hra1129/msx0keyboard/README.md

新プロトコルに関しては、MSX0に採用されるかどうかも分かりませんし、現時点のバージョンではサポートされていませんので、
新バージョンの方は使える環境はありません。未テストです。

キーボードに付いている Grove端子には、プルアップ抵抗(3.3kΩ)を付けなければ機能しません。
G32とG33の二カ所を 3.3kΩ経由で 5V に繋いでください。
