hra1129/msx0keyboard/RaspberryPiPico_Arduino_Sketch/Readme.txt

../KiCad_Project/msx0_keyboard の基板用ファームウェアです。
このファームウェアは２種類のプロトコルを扱います。

	(1) FaceII_keyboard_compatible
		こちらの通信プロトコルは、FaceIIキーボードのプロトコルを使うバージョンです。
		現時点で利用可能である反面、プロトコルの都合によりいくつかのキーを
		入力できない問題があります。

	(2) NewProtocol_MSX0_keyboard  ★こちらがやりたい方！
		こちらの通信プロトコルは、新プロトコルになっております。
		MSX0側が対応していただかなければ、このファームウェアで入力できません。
		対応していただければ、実MSXと同じキー入力を実現できます。
		MSXのキーマトリクス＋ジョイパッド情報を、MSXのPPIの並び順＋PSGの並び順で返すので、
		MSX0本体側もそれをそのまま使えば良く、CPU負荷にも優しいプロトコルになっています。
