hra1129/msx0keyboard/KiCad_Project/readme.txt

それぞれのフォルダにある zip ファイルを、
JLCPCB にアップロードすると発注できます。

m5stack_base は 1mm厚で作って下さい。
ここに M5stack用のピンヘッダを取り付ければ MSX0を取り付けられるようになります。

他は デフォルトの 1.6mm厚で問題ありません。
