hra1129/msx0keyboard/(list of files, drawings)

Other design files:
KiCad_Project/msx0_keyboard/msx0_keyboard.dsn
KiCad_Project/msx0_keyboard_frontpanel/msx0_keyboard.dsn
