hra1129/msx0keyboard/KiCad_Project/m5stack_base/m5stack_base.kicad_pcb

## KiCad design KiCad_Project/m5stack_base/m5stack_base.kicad_pcb (2024-04-21)

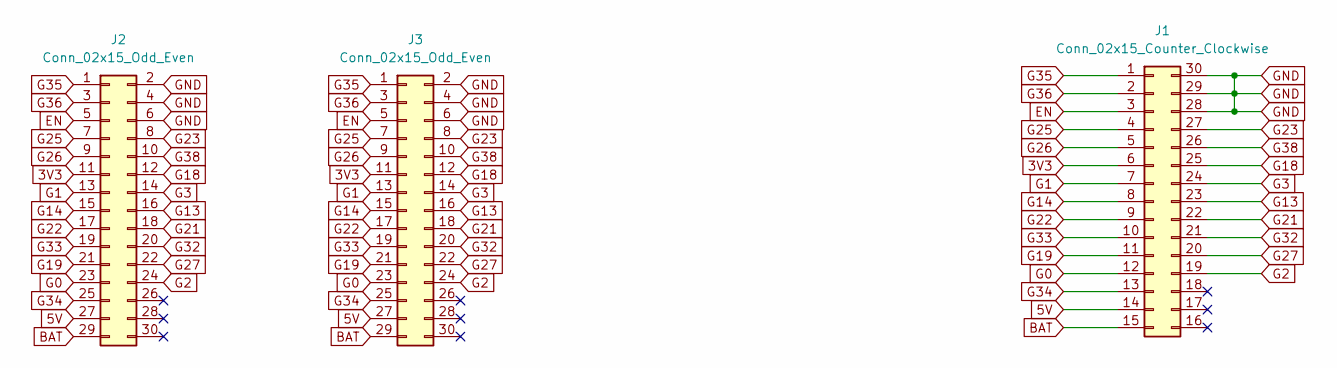
[picture p13: schematic m5stack_base.kicad_sch]

Parts:
J1: Conn_02x15_Counter_Clockwise; M5StackBase2_1
J2, J3: Conn_02x15_Odd_Even; PinHeader_2x15_P2.54mm_Vertical

Connections:
3V3: J1.6, J2.11, J3.11
5V: J1.14, J2.27, J3.27
BAT: J1.15, J2.29, J3.29
EN: J1.3, J2.5, J3.5
G0: J1.12, J2.23, J3.23
G1: J1.7, J2.13, J3.13
G2: J1.19, J2.24, J3.24
G3: J1.24, J2.14, J3.14
G13: J1.23, J2.16, J3.16
G14: J1.8, J2.15, J3.15
G18: J1.25, J2.12, J3.12
G19: J1.11, J2.21, J3.21
G21: J1.22, J2.18, J3.18
G22: J1.9, J2.17, J3.17
G23: J1.27, J2.8, J3.8
G25: J1.4, J2.7, J3.7
G26: J1.5, J2.9, J3.9
G27: J1.20, J2.22, J3.22
G32: J1.21, J2.20, J3.20
G33: J1.10, J2.19, J3.19
G34: J1.13, J2.25, J3.25
G35: J1.1, J2.1, J3.1
G36: J1.2, J2.3, J3.3
G38: J1.26, J2.10, J3.10
GND: J1.28, J1.29, J1.30, J2.2, J2.4, J2.6, J3.2, J3.4, J3.6

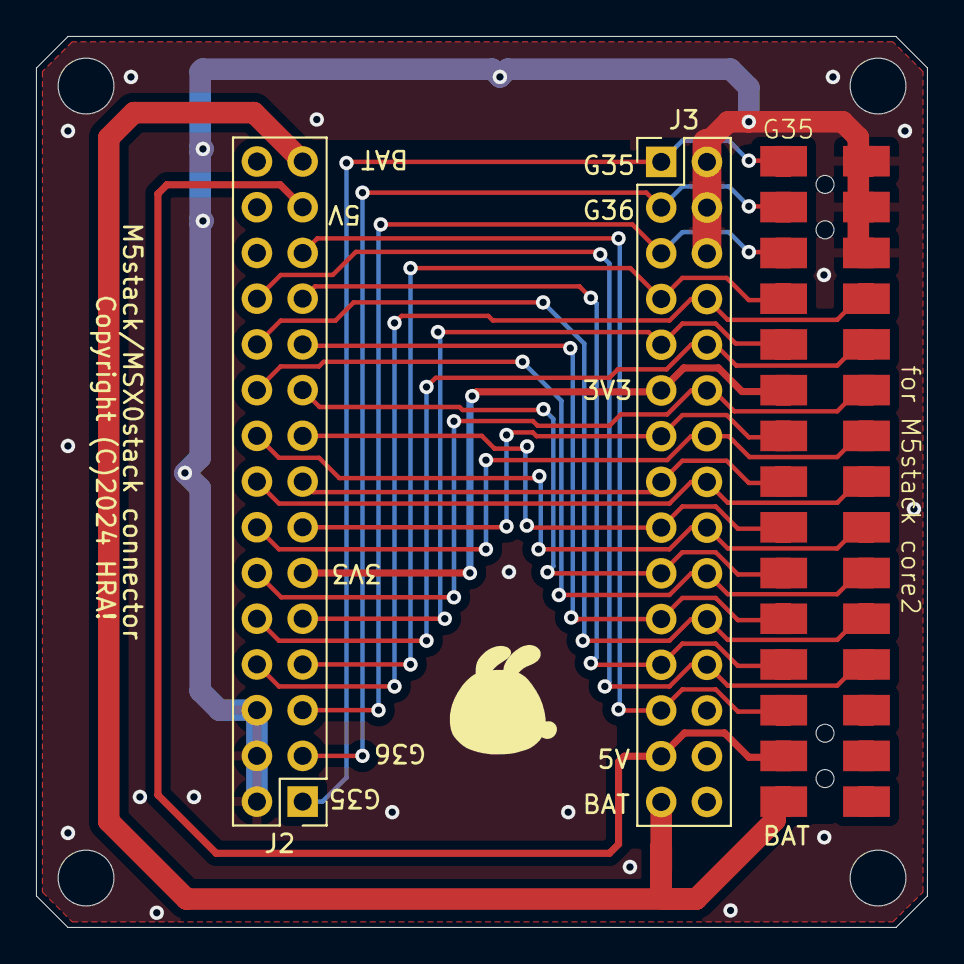
[picture p14: board m5stack_base.kicad_pcb from above]

Board: 2 copper layers, 49.5 x 49.5 mm, 3 parts (0 on the bottom side), 25 nets.
