hra1129/msx0keyboard/KiCad_Project/msx0_keyboard/msx0_keyboard.kicad_pcb

## KiCad design KiCad_Project/msx0_keyboard/msx0_keyboard.kicad_pcb (2024-04-21)

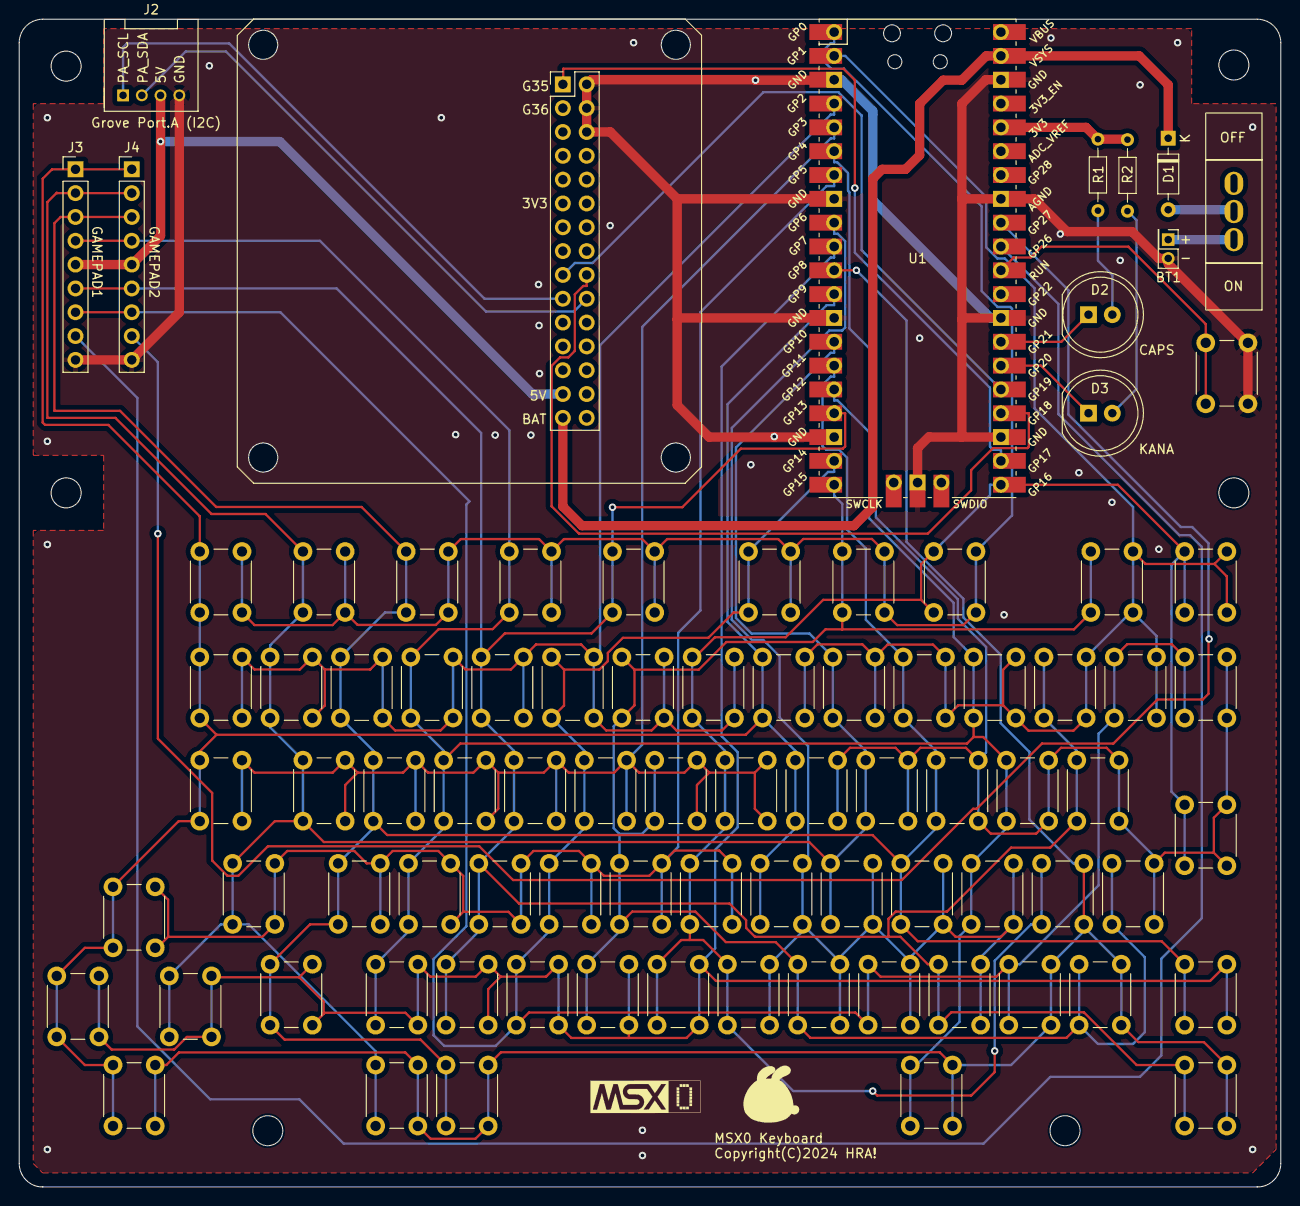
[picture p15: board msx0_keyboard.kicad_pcb from above]

Board: 2 copper layers, 134.5 x 124.5 mm, 93 parts (0 on the bottom side), 35 nets.

Parts:
BT1: Battery_Cell; PinHeader_2x01_P2.00mm_Vertical
D1: 1N914; D_DO-35_SOD27_P7.62mm_Horizontal
D2, D3: LED; LED_D8.0mm
HOLE0, HOLE1, HOLE2, HOLE3, HOLE4, HOLE5: MountingHole_3.2mm_M3
J1: M5stack Connector; M5StackConnect
J2: Conn_01x04_Pin; HW4-2.0-90D
J3, J4: DE9_Plug; PinHeader_1x09_P2.54mm_Vertical
MSX0: LOGO; MSX0_logo_15mm
R1, R2: R; R_Axial_DIN0204_L3.6mm_D1.6mm_P7.62mm_Horizontal
SW1: F1; SW_PUSH_6mm
SW2: F2; SW_PUSH_6mm
SW3: F3; SW_PUSH_6mm
SW4: F4; SW_PUSH_6mm
SW5: F5; SW_PUSH_6mm
SW6: STOP; SW_PUSH_6mm
SW7: CLS; SW_PUSH_6mm
SW8: SELECT; SW_PUSH_6mm
SW9: INS; SW_PUSH_6mm
SW10: DEL; SW_PUSH_6mm
SW11: ESC; SW_PUSH_6mm
SW12: 1; SW_PUSH_6mm
SW13: 2; SW_PUSH_6mm
SW14: 3; SW_PUSH_6mm
SW15: 4; SW_PUSH_6mm
SW16: 5; SW_PUSH_6mm
SW17: 6; SW_PUSH_6mm
SW18: 7; SW_PUSH_6mm
SW19: 8; SW_PUSH_6mm
SW20: 9; SW_PUSH_6mm
SW21: 0; SW_PUSH_6mm
SW22: -; SW_PUSH_6mm
SW23: ^; SW_PUSH_6mm
SW24: ￥; SW_PUSH_6mm
SW25: BS; SW_PUSH_6mm
SW26: TAB; SW_PUSH_6mm
SW27: Q; SW_PUSH_6mm
SW28: W; SW_PUSH_6mm
SW29: E; SW_PUSH_6mm
SW30: R; SW_PUSH_6mm
SW31: T; SW_PUSH_6mm
SW32: Y; SW_PUSH_6mm
SW33: U; SW_PUSH_6mm
SW34: I; SW_PUSH_6mm
SW35: O; SW_PUSH_6mm
SW36: P; SW_PUSH_6mm
SW37: @; SW_PUSH_6mm
SW38: [; SW_PUSH_6mm
SW39: RETURN; SW_PUSH_6mm
SW40: CTRL; SW_PUSH_6mm
SW41: A; SW_PUSH_6mm
SW42: S; SW_PUSH_6mm
SW43: D; SW_PUSH_6mm
SW44: F; SW_PUSH_6mm
SW45: G; SW_PUSH_6mm
SW46: H; SW_PUSH_6mm
SW47: J; SW_PUSH_6mm
SW48: K; SW_PUSH_6mm
SW49: L; SW_PUSH_6mm
SW50: ;; SW_PUSH_6mm
SW51: :; SW_PUSH_6mm
SW52: ]; SW_PUSH_6mm
SW53, SW65: SHIFT; SW_PUSH_6mm
SW54: Z; SW_PUSH_6mm
SW55: X; SW_PUSH_6mm
SW56: C; SW_PUSH_6mm
SW57: V; SW_PUSH_6mm
SW58: B; SW_PUSH_6mm
SW59: N; SW_PUSH_6mm
SW60: M; SW_PUSH_6mm
SW61: ,; SW_PUSH_6mm
SW62: .; SW_PUSH_6mm
SW63: /; SW_PUSH_6mm
SW64: _; SW_PUSH_6mm
SW66: CAPS; SW_PUSH_6mm
SW67: GRPH; SW_PUSH_6mm
SW68: SPACE; SW_PUSH_6mm
SW69: KANA; SW_PUSH_6mm
SW70: ←; SW_PUSH_6mm
SW71: →; SW_PUSH_6mm
SW72: ↑; SW_PUSH_6mm
SW73: ↓; SW_PUSH_6mm
SW74: SW_MEC_5G; SW_PUSH_6mm
SW75: SW_SPST; Slide Switch
U1: Pico; RPi_Pico_SMD_TH

Connections:
/BAT: D1.1 (K), J1.29, U1.39 (VSYS)
GND: BT1.2 (-), J1.2, J1.4, J1.6, J2.4, J3.9, J4.9, SW74.2 (A), U1.3 (GND), U1.8 (GND), U1.13 (GND), U1.18 (GND), U1.23 (GND), U1.28 (GND), U1.33 (AGND), U1.38 (GND), U1.42 (GND)
INT_SCL: J1.17, U1.25 (GPIO19)
INT_SDA: J1.18, U1.24 (GPIO18)
KEY_INT: J1.1, U1.22 (GPIO17)
unnamed: BT1.1 (+), SW75.1 (A)
unnamed: D1.2 (A), SW75.2 (B)
unnamed: D2.2 (A), R1.1
unnamed: D2.1 (K), U1.27 (GPIO21)
unnamed: D3.2 (A), R2.1
unnamed: D3.1 (K), U1.26 (GPIO20)
unnamed: R1.2, R2.2, U1.36 (3V3)
unnamed: SW74.1 (A), U1.30 (RUN)
PA_5V: J1.27, J2.3, J3.5, J4.5
PA_SCL: J1.19, J2.1
PA_SDA: J1.20, J2.2
X0: J3.1, J4.1, SW1.1, SW11.1, SW19.1, SW26.1, SW34.1, SW47.1, SW70.1, SW72.1, SW73.1, U1.12 (GPIO9)
X1: J3.2, J4.2, SW2.1, SW12.1, SW20.1, SW27.1, SW35.1, SW40.1, SW48.1, SW66.1, SW71.1, U1.14 (GPIO10)
X2: J3.3, J4.3, SW3.1, SW13.1, SW21.1, SW28.1, SW36.1, SW41.1, SW49.1, SW53.1, SW65.1, SW67.1, U1.15 (GPIO11)
X3: J3.4, J4.4, SW4.1, SW14.1, SW22.1, SW29.1, SW37.1, SW42.1, SW50.1, SW54.1, SW68.1, U1.16 (GPIO12)
X4: J3.6, J4.6, SW5.1, SW15.1, SW23.1, SW30.1, SW38.1, SW43.1, SW55.1, SW62.1, SW69.1, U1.17 (GPIO13)
X5: J3.7, J4.7, SW6.1, SW16.1, SW24.1, SW25.1, SW31.1, SW44.1, SW56.1, SW61.1, SW63.1, U1.19 (GPIO14)
X6: SW7.1, SW9.1, SW17.1, SW32.1, SW45.1, SW52.1, SW57.1, SW60.1, SW64.1, U1.20 (GPIO15)
X7: SW8.1, SW10.1, SW18.1, SW33.1, SW39.1, SW46.1, SW51.1, SW58.1, SW59.1, U1.21 (GPIO16)
Y0: SW1.2, SW2.2, SW3.2, SW4.2, SW5.2, SW6.2, SW7.2, SW8.2, U1.1 (GPIO0)
Y1: SW9.2, SW10.2, SW19.2, SW20.2, SW21.2, SW22.2, SW23.2, SW24.2, U1.2 (GPIO1)
Y2: SW11.2, SW12.2, SW13.2, SW14.2, SW15.2, SW16.2, SW17.2, SW18.2, U1.4 (GPIO2)
Y3: SW26.2, SW27.2, SW28.2, SW29.2, SW30.2, SW31.2, SW32.2, SW33.2, U1.5 (GPIO3)
Y4: SW25.2, SW34.2, SW35.2, SW36.2, SW37.2, SW38.2, SW39.2, SW52.2, U1.6 (GPIO4)
Y5: SW40.2, SW41.2, SW42.2, SW43.2, SW44.2, SW45.2, SW46.2, SW72.2, U1.7 (GPIO5)
Y6: SW47.2, SW48.2, SW49.2, SW50.2, SW59.2, SW60.2, SW61.2, SW62.2, U1.9 (GPIO6)
Y7: SW53.2, SW54.2, SW55.2, SW56.2, SW57.2, SW58.2, SW65.2, SW70.2, SW71.2, U1.10 (GPIO7)
Y8: SW51.2, SW63.2, SW64.2, SW66.2, SW67.2, SW68.2, SW69.2, SW73.2, U1.11 (GPIO8)
Y9: J3.8, U1.31 (GPIO26_ADC0)
Y10: J4.8, U1.32 (GPIO27_ADC1)
