hra1129/msx0keyboard/(commit log)

2024-04-28 Updated
    新ボードの LED に対応。
2024-08-07 Updated
    FaceII 互換モードにおいて、( ) { } [ ] あたりの入力がおかしかったバグを修正。
    [face2keymap.cpp]
2024-08-12 組み立て説明書を追加
    [FaceIIkeyboard.xlsx]
2024-08-13 Updated
    仮名入力が出来なかった問題を修正
    [FaceIIkeyboard.xlsx]
