hra1129/msx0keyboard/(notices)

Notices in the files:
KiCad_Project/msx0_keyboard/msx0_keyboard.kicad_pcb:
Copyright(C)2024 HRA!
